KaiManabe/mixer-fader/documents/02.basic-design/basic-design.md

# 基本設計

## ハードウェア構成
### 主要構成要素 - マスターデバイス
- 1x PCB
  - KiCad9.0で設計
  - JLCPCBに発注
- 1x USB type-cメス
- 1x 0.96インチ 80x160px ST7735S搭載IPSディスプレイモジュール
- 2x ロータリーエンコーダ
  - クリック必須
  - プッシュスイッチ必須
- 1x レベルメータ
  - 1x 赤チップLED
  - 5x 橙チップLED
  - 10x 緑チップLED
  - 1x LEDドライバ(TLC5928)
- 1x メス通信端子
  - 3x 5pin ポゴピンコネクタ (メス)
- エンクロージャ
  - 自作もしくはJLC3DP

### 主要構成要素 - スレーブデバイス
- 1x PCB
  - KiCad9.0で設計
  - JLCPCBに発注
- 1x 0.96インチ 80x160px ST7735S搭載IPSディスプレイモジュール
- 1x ロータリーエンコーダ
  - クリック必須
  - プッシュスイッチ必須
- 1x レベルメータ
  - 1x 赤チップLED
  - 5x 橙チップLED
  - 10x 緑チップLED
  - 1x LEDドライバ(TLC5928)
- 1x メス通信端子
  - 3x 5pin ポゴピンコネクタ (メス)
- 1x オス通信端子
  - 3x 5pin ポゴピンコネクタ (オス)
- エンクロージャ
  - 自作もしくはJLC3DP

### 主要構成要素 - エンドキャップ
- 1x PCB
  - KiCad9.0で設計
  - JLCPCBに発注
- 1x オス通信端子
  - 3x 5pin ポゴピンコネクタ (オス)
- エンクロージャ
  - 自作もしくはJLC3DP

## ソフトウェア構成
### ファームウェア
- RP2040 SDKを使用
- C++で実装

#### USB通信
- tinyUSBでGeneric HIDとして振る舞う
  - 開発中はダミーVID/PIDを使用
- 通信フロー
  1. デバイスはサウンドを出力しているアプリケーションの数を要求
  2. winは要求された情報を送信
  3. デバイスは$n$番目のアプリケーションのアイコン，設定音量，レベルを要求
  4. winは要求された情報を送信
  5. 必要に応じて，3,4を繰り返し

#### スレーブ通信
- D-FFおよびシフトレジスタを利用したデイジーチェーン接続を4系統実装
  - 液晶モジュールとのSPI通信のCS信号用 (マスター -> スレーブ)
  - レベルメータのLED用 (マスター -> スレーブ)
  - ロータリーエンコーダの信号選択用 (スレーブ -> マスター)
  - ロータリーエンコーダのプッシュスイッチ用 (スレーブ -> マスター)

### ドライバ
- WASAPIを使用
- C++で実装

#### データ取得・設定
- WASAPIより以下の情報を取得
  - 既定のデバイスから音量を出力するアプリ
  - アプリのアイコン
  - マスターおよび各アプリの設定音量
  - マスターおよび各アプリのミュート情報
  - マスターおよび各アプリの出力レベル
- マスターからの要求に応じて以下の情報を設定
  - マスターもしくは指定アプリの設定音量
  - マスターもしくは指定アプリのミュート

#### USB通信
- VID/PIDによりマスターデバイスを検出
- 検出後，マスターが要求する情報を返し続ける
  - 必要に応じてWASAPI経由で音量設定

## リポジトリ構成
- common/
  - include/*.hpp
    - ファームウェア・ドライバで共通するヘッダを格納
    - 構造体・シリアライザなど
- documents/
  - 01.requirements-definition/*.md
    - 要件定義書
  - 02.basic-design/*.md
    - 基本設計書
  - 03.detailed-design/*.md
    - 詳細設計書
- driver/
  - bin/*.exe
    - 出力exeファイル(git追跡なし)
  - build/*.o
    - ビルドファイル(git追跡なし)
  - include/*.hpp
  - src/*.cpp
  - Makefile
- enclosure/
  - master/*.f3d
    - マスターデバイス用のエンクロージャ
    - Fusion 360プロジェクトファイル
  - slave/*.f3d
    - スレーブデバイス用のエンクロージャ
    - Fusion 360プロジェクトファイル
- firmware/mixer-fader/
  - (RP2040プロジェクトのroot)
  - include/*.hpp
  - src/*.cpp
  - ...
- pcb/mixer-fader/
  - common/footprints
    - フットプリントをすべて配置
  - common/symbols
    - シンボルをすべて配置
  - common/sheets
    - 階層シートをすべて配置
  - master/*
    - KiCadプロジェクトのroot
  - slave/*
    - KiCadプロジェクトのroot
  - endcap/*
    - KiCadプロジェクトのroot
- LICENSE
- README.md
