KaiManabe/mixer-fader/documents/03.detailed-design/enclosure.md

# CAD 詳細設計

## 構成要素
- 1x 筐体
  - マスター用およびスレーブ用を製作
  - 不透明
- 1x レベルメータ用遮光スペーサ
  - 不透明 Black Resin
- 1x レベルメータ用窓
  - 半透明 8001 Resin - Translucent
- 1x LCD用窓
  - 透明 8001 Resin - Transparent
- 1x LCD用スペーサ
  - 素材はなんでもいい

## 要件
### 共通
- PCB正面と筐体裏面の距離は6.5mmとする
  - ロータリーエンコーダに合わせる
- 筐体の厚さは3mmとする

### マスター筐体
- 左側面にUSB-typeCのメスコネクタを刺す穴を持つこと
  - **挿入時，干渉しないこと**
- 左側面にUART用のXHコネクタをに持つこと
  - **挿入時，干渉しないこと**
- 正面にロータリーエンコーダ用の取付穴を2つ持つこと
  - ページ送り用
  - マスターボリューム用
- 正面にLCD用の窓を持つこと
- 正面にレベルメータ用の窓を持つこと
- 右側面にスレーブ接続用の端子を持つこと
  - ダイソーのネオジム磁石を埋め込む穴を持つこと
  - ポゴピンがしっかり接触すること

### スレーブ筐体
- 正面にロータリーエンコーダ用の取付穴を持つこと
  - ボリューム用
- 正面にLCD用の窓を持つこと
- 正面にレベルメータ用の窓を持つこと
- 左側面および右側面にスレーブ接続用の端子を持つこと
  - ダイソーのネオジム磁石を埋め込む穴を持つこと
  - ポゴピンがしっかり接触すること
