KaiManabe/mixer-fader/enclosure/display/spacer.step

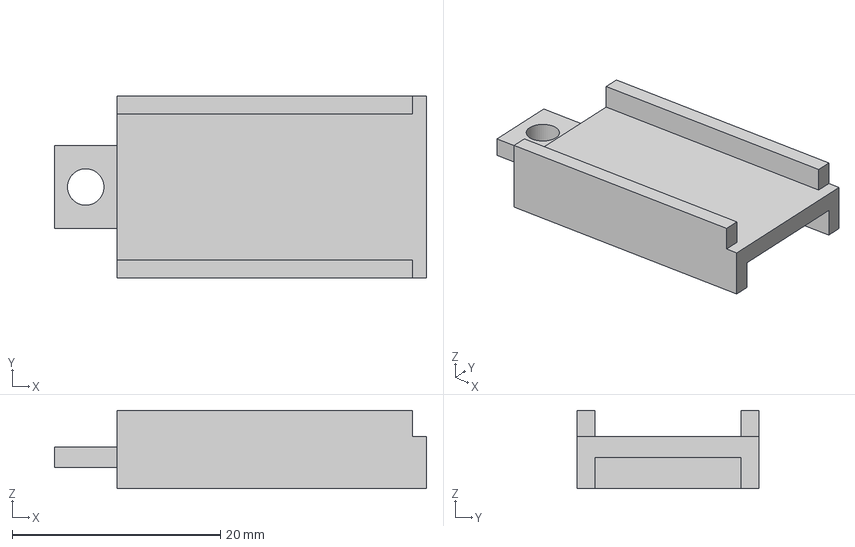
[picture p9: CAD file, 2026-01-30]
enclosure/display/spacer.step
35.8 x 17.5 x 7.50 mm
