KaiManabe/mixer-fader/enclosure/level-meter/spacer/footprint.dxf

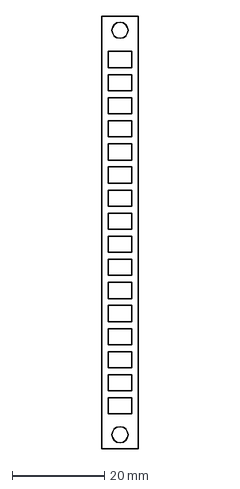
[picture p10: CAD file, 2026-01-30]
enclosure/level-meter/spacer/footprint.dxf
8.00 x 93.6 mm
