KaiManabe/mixer-fader/enclosure/level-meter/window/window.step

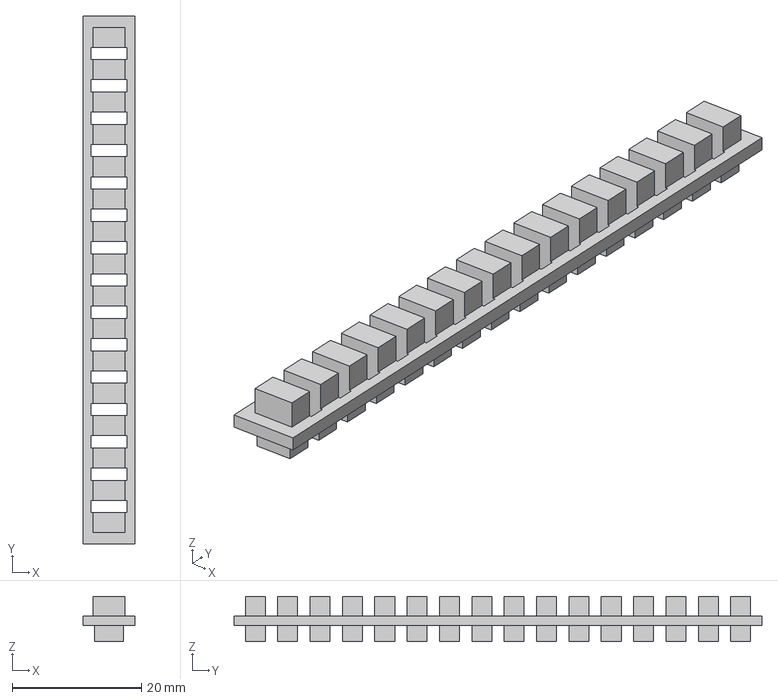
[picture p11: CAD file, 2026-01-30]
enclosure/level-meter/window/window.step
8.00 x 81.6 x 7.00 mm
