KaiManabe/mixer-fader/pcb/mixer-fader/endcap/endcap.step

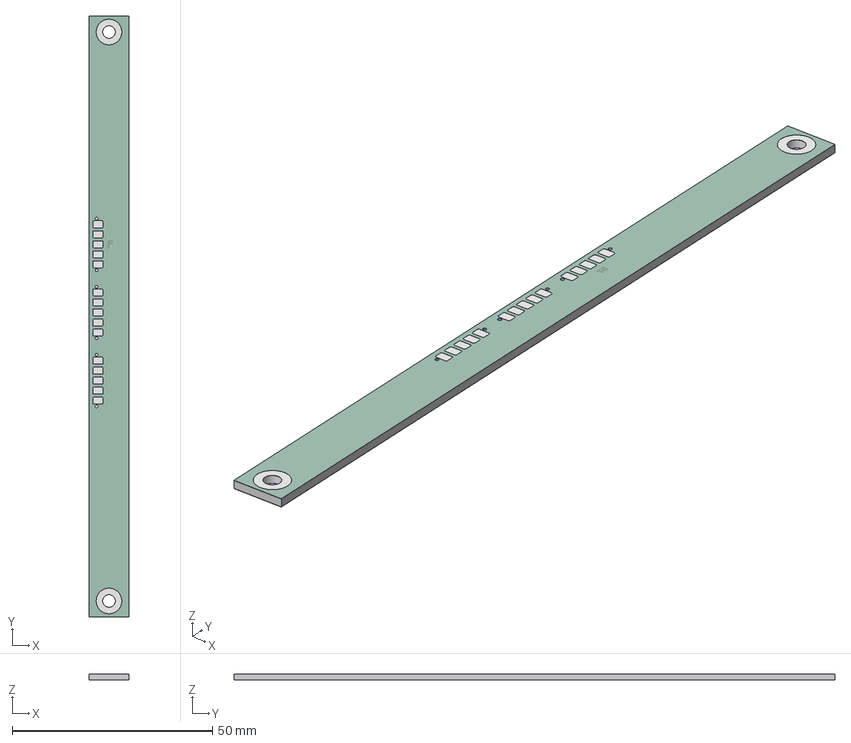
[picture p12: CAD file, 2026-01-30]
pcb/mixer-fader/endcap/endcap.step
10.0 x 150.0 x 1.64 mm
endcap_copper
endcap_pad
endcap_silkscreen
endcap_soldermask x 2
endcap_PCB
