KaiManabe/mixer-fader/pcb/mixer-fader/slave/slave.step

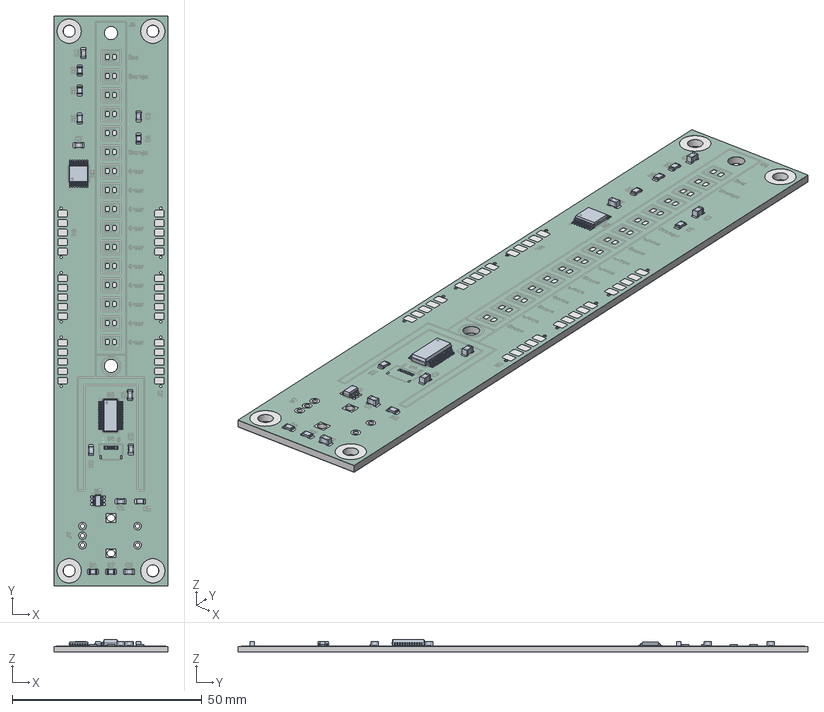
[picture p13: CAD file, 2026-01-30]
pcb/mixer-fader/slave/slave.step
30.0 x 150.0 x 3.29 mm
R_0805_2012Metric x 8
C_0805_2012Metric x 7
SC-74-6_1.55x2.9mm_P0.95mm
TSSOP-16_4.4x5mm_P0.65mm
SSOP-24_3.9x8.7mm_P0.635mm
slave_copper
slave_pad
slave_via
slave_silkscreen
slave_soldermask x 2
slave_PCB
