KaiManabe/mixer-fader/enclosure/display/window.step

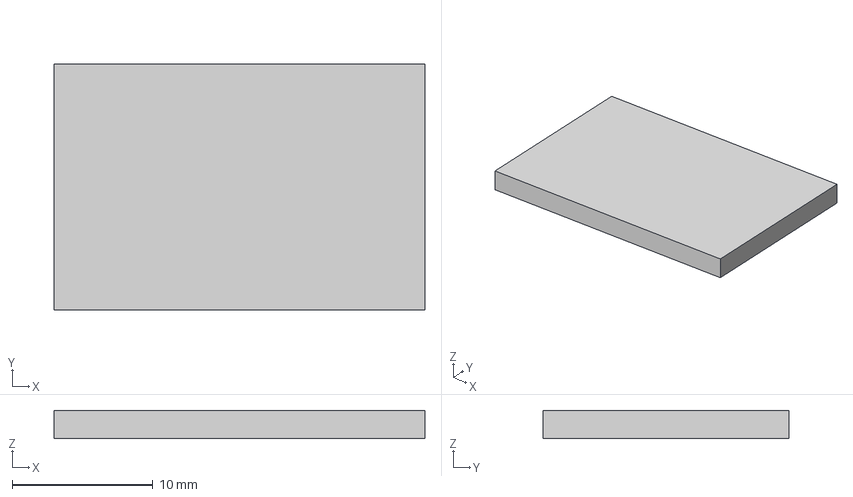
[picture p14: CAD file, 2026-01-30]
enclosure/display/window.step
26.4 x 17.5 x 2.00 mm
