KaiManabe/mixer-fader/enclosure/level-meter/spacer/spacer.step

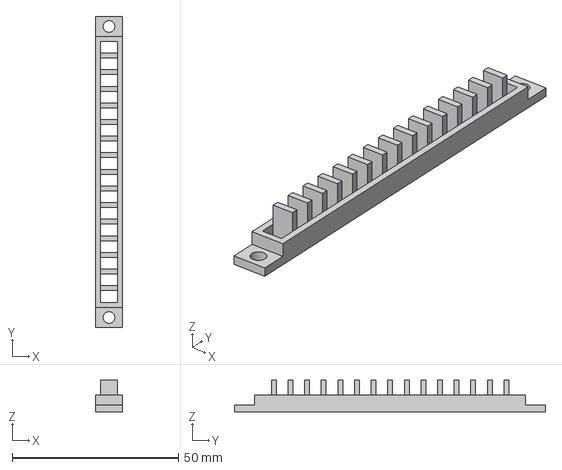
[picture p15: CAD file, 2026-01-30]
enclosure/level-meter/spacer/spacer.step
8.00 x 93.6 x 9.50 mm
