KaiManabe/mixer-fader/enclosure/display/footprint.dxf

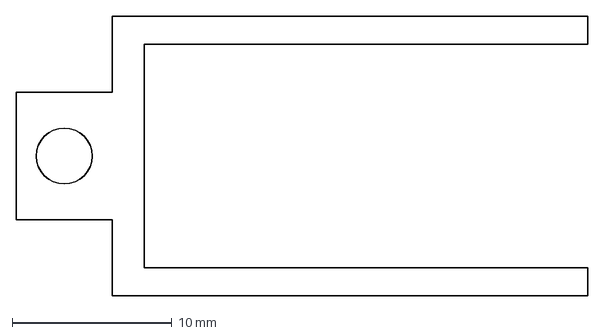
[picture p16: CAD file, 2026-01-30]
enclosure/display/footprint.dxf
35.8 x 17.5 mm
