KaiManabe/mixer-fader/(list of files, cad)

Other CAD files:
enclosure/display/display.f3d
enclosure/level-meter/spacer/spacer.f3d
enclosure/level-meter/window/window.f3d
