KaiManabe/mixer-fader/pcb/mixer-fader/master/master.kicad_pcb

## KiCad design pcb/mixer-fader/master/master.kicad_pcb (2026-01-30)

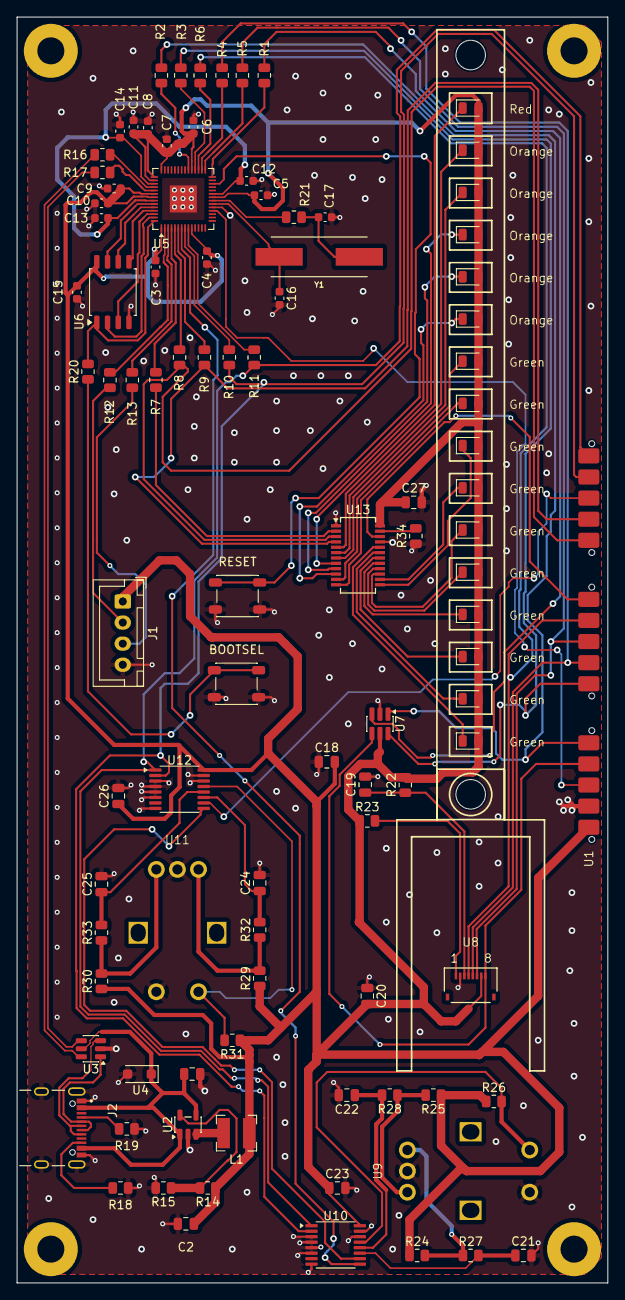
[picture p17: board master.kicad_pcb from above]

Board: 2 copper layers, 70.0 x 150.0 mm, 81 parts (0 on the bottom side), 86 nets.

Parts:
BOOTSEL: BOOTSEL; SW_SPST_PTS647_Sx50
C1, C2: 10u; C_0805_2012Metric
C3, C4, C5, C6, C7, C8, C9, C10, C12, C13, C15: 0.1u; C_0603_1608Metric
C11, C14: 1u; C_0603_1608Metric
C16, C17: 27p; C_0603_1608Metric
C18, C19, C20, C23, C26, C27: 0.1u; C_0805_2012Metric
C21, C22, C24, C25: 0.01u; C_0805_2012Metric
J1: UART_SOCKET; JST_XH_B4B-XH-A_1x04_P2.50mm_Vertical
J2: UJ20-C-H-G-SMT-1-P16-TR
L1: 2.2u; L_Bourns-SRN4018
R1, R2, R3, R4, R5, R6, R7, R8, R9, R10, R11, R16, R17: 27; R_0805_2012Metric
R12, R13: 100; R_0805_2012Metric
R14: 453k; R_0805_2012Metric
R15: 100k; R_0805_2012Metric
R18, R19: 5.1k; R_0805_2012Metric
R20, R21: 1k; R_0805_2012Metric
R22, R24, R25, R26, R27, R28, R29, R30, R31, R32, R33: 10k; R_0805_2012Metric
R23: 18; R_0805_2012Metric
R34: 2.7k; R_0805_2012Metric
RESET: RESET; SW_SPST_PTS647_Sx50
U1: MixerFader_PogoPin_Male; 3x_PogoPinConnector_SMD_Male_01x05
U2: TLV62568DBV; SOT-23-5
U3: USBLC6-2SC6; SOT-23-6
U4: SMF5.0CA; D_SOD-123F
U5: RP2040; QFN-56-1EP_7x7mm_P0.4mm_EP3.2x3.2mm
U6: W25Q128JVS; SOIC-8_5.3x5.3mm_P1.27mm
U7: 74LVC1G175; SC-74-6_1.55x2.9mm_P0.95mm
U8: ST7735_FPC; ST7735_PFC_Inverted
U9, U11: EC11
U10, U12: 74LV165PW-Q100J; TSSOP-16_4.4x5mm_P0.65mm
U13: TLC59283DBQR; SSOP-24_3.9x8.7mm_P0.635mm
U14: LevelMeter_16
Y1: ABLS-12.000MHZ-B4-T

Connections:
+3V3: C2.1, C3.1, C4.1, C5.1, C6.1, C7.1, C8.1, C9.1, C10.1, C11.1, C15.1, C18.2, C20.2, C23.1, C26.1, C27.1, J1.1, L1.2, R14.1, R22.2, R23.1, R24.1, R25.1, R26.1, R29.1, R30.1, R31.1, U1.1 (3.3V), U5.1 (IOVDD), U5.10 (IOVDD), U5.22 (IOVDD), U5.33 (IOVDD), U5.42 (IOVDD), U5.43 (ADC_AVDD), U5.44 (VREG_VIN), U5.48 (USB_VDD), U5.49 (IOVDD), U6.8 (VCC), U7.5 (VCC), U8.7 (VCC), U10.16 (VCC), U12.16 (VCC), U13.24 (VCC), U14.2, U14.4, U14.6, U14.8, U14.10, U14.12, U14.14, U14.16, U14.18, U14.20, U14.22, U14.24, U14.26, U14.28, U14.30, U14.32
/Master_Display/DFF-CLK: R2.2, U1.5 (DISP_DFF_CLK), U7.1 (CLK)
/Master_Display/DFF-CLR: R3.2, U1.6 (DISP_DFF_CLR), U7.6 (~CLR)
/Master_Display/DFF-D: R1.2, U7.3 (D)
/Master_Display/DFF-Q: U1.4 (DISP_DFF_D), U7.4 (Q), U8.8 (CS)
/Master_Display/SPI-CLK: R5.2, U1.8 (DISP_SPI_CLK), U8.6 (SCL)
/Master_Display/SPI-DC: R6.2, U1.9 (DISP_DC), U8.4 (DC)
/Master_Display/SPI-MOSI: R4.2, U1.7 (DISP_SPI_MOSI), U8.5 (SDA)
/Master_LevelMeter/CLK: R8.2, U1.11 (LED_CLK), U13.3 (SCLK)
/Master_LevelMeter/DATA-IN: R7.2, U13.2 (SIN)
/Master_LevelMeter/DATA-OUT: U1.10 (LED_DATA), U13.22 (SOUT)
/Master_LevelMeter/LATCH: R9.2, U1.12 (LED_LATCH), U13.4 (LAT)
/Page_Encoder/CLK: R10.2, U1.14 (ENC_LATCH), U10.2 (CP), U12.2 (CP)
/Page_Encoder/DATA-IN: U1.13 (ENC_DATA), U12.10 (DS)
/Page_Encoder/DATA-OUT: U10.10 (DS), U12.9 (Q7)
/Page_Encoder/LATCH: R11.2, U1.15 (ENC_CLK), U10.1 (~PL), U12.1 (~PL)
/RP2040/1.1V: C12.1, C13.1, C14.1, U5.23 (DVDD), U5.45 (VREG_VOUT), U5.50 (DVDD)
/RP2040/GPIO0: R12.1, U5.2 (GPIO0)
/RP2040/GPIO1: R13.1, U5.3 (GPIO1)
/RP2040/GPIO2: R7.1, U5.4 (GPIO2)
/RP2040/GPIO3: R8.1, U5.5 (GPIO3)
/RP2040/GPIO4: R9.1, U5.6 (GPIO4)
/RP2040/GPIO5: U5.7 (GPIO5), U10.9 (Q7)
/RP2040/GPIO6: R10.1, U5.8 (GPIO6)
/RP2040/GPIO7: R11.1, U5.9 (GPIO7)
/RP2040/GPIO15: U1.3 (DISP_LOOPBACK), U5.18 (GPIO15)
/RP2040/GPIO17: R1.1, U5.28 (GPIO17)
/RP2040/GPIO18: R5.1, U5.29 (GPIO18)
/RP2040/GPIO19: R4.1, U5.30 (GPIO19)
/RP2040/GPIO20: R6.1, U5.31 (GPIO20)
/RP2040/GPIO21: R3.1, U5.32 (GPIO21)
/RP2040/GPIO22: R2.1, U5.34 (GPIO22)
/RP2040/QSPI_SCLK: U5.52 (QSPI_SCLK), U6.6 (CLK)
/RP2040/QSPI_SD0: U5.53 (QSPI_SD0), U6.5 (DI/IO_{0})
/RP2040/QSPI_SD1: U5.55 (QSPI_SD1), U6.2 (DO/IO_{1})
/RP2040/QSPI_SD2: U5.54 (QSPI_SD2), U6.3 (~WP/IO_{2})
/RP2040/QSPI_SD3: U5.51 (QSPI_SD3), U6.7 (~HOLD/~RESET/IO_{3})
/RP2040/RUN: RESET.1, U5.26 (RUN)
/RP2040/USB_DN: R16.1, U3.6 (I/O1)
/RP2040/USB_DP: R17.1, U3.4 (I/O2)
/RP2040/USB_VBUS: C1.1, J2.A4_B9 (VBUS), J2.B4_A9 (VBUS__1), U2.1 (EN), U2.4 (VIN), U3.5 (VBUS), U4.1
/RP2040/XIN: C16.1, U5.20 (XIN), Y1.1
/RP2040/XOUT: R21.2, U5.21 (XOUT)
/RP2040/~QSPI_SS: R20.2, U5.56 (~QSPI_SS), U6.1 (~CS)
/RP2040/~USB_BOOT: BOOTSEL.1, R20.1
GND: BOOTSEL.2, C1.2, C2.2, C3.2, C4.2, C5.2, C6.2, C7.2, C8.2, C9.2, C10.2, C11.2, C12.2, C13.2, C14.2, C15.2, C16.2, C17.2, C18.1, C19.2, C20.1, C21.2, C22.2, C23.2, C24.2, C25.2, C26.2, C27.2, J1.4, J2.A1_B12 (GND), J2.B1_A12 (GND__1), J2.SH1 (SHIELD), J2.SH2 (SHIELD__1), J2.SH3 (SHIELD__2), J2.SH4 (SHIELD__3), R15.2, R18.2, R19.2, R34.1, RESET.2, U1.2 (GND), U2.2 (GND), U3.2 (GND), U4.2, U5.19 (TESTEN), U5.57 (GND), U6.4 (GND), U7.2 (GND), U8.2 (GND), U9.C, U9.S1, U10.3 (D4), U10.4 (D5), U10.5 (D6), U10.6 (D7), U10.8 (GND), U10.14 (D3), U10.15 (~CE), U11.C, U11.S1, U12.3 (D4), U12.4 (D5), U12.5 (D6), U12.6 (D7), U12.8 (GND), U12.14 (D3), U12.15 (~CE), U13.1 (GND), U13.21 (BLANK)
unnamed: C17.1, R21.1, Y1.2
unnamed: J1.2, R12.2
unnamed: J1.3, R13.2
unnamed: J2.A5 (CC1), R19.1
unnamed: J2.B5 (CC2), R18.1
unnamed: J2.A7 (DN1), J2.B7 (DN2), U3.1 (I/O1)
unnamed: J2.A6 (DP1), J2.B6 (DP2), U3.3 (I/O2)
unnamed: R24.2, R27.1, U9.A
unnamed: R25.2, R28.1, U9.B
unnamed: R29.2, R32.1, U11.A
unnamed: R30.2, R33.1, U11.B
unnamed: R14.2, R15.1, U2.5 (FB)
unnamed: L1.1, U2.3 (SW)
unnamed: R16.2, U5.46 (USB_DM)
unnamed: R17.2, U5.47 (USB_DP)
unnamed: R23.2, U8.1 (LEDA)
unnamed: C19.1, R22.1, U8.3 (RESET)
unnamed: C21.1, R27.2, U10.11 (D0)
unnamed: C22.1, R28.2, U10.12 (D1)
unnamed: R26.2, U9.S2, U10.13 (D2)
unnamed: C24.1, R32.2, U12.11 (D0)
unnamed: C25.1, R33.2, U12.12 (D1)
unnamed: R31.2, U11.S2, U12.13 (D2)
unnamed: R34.2, U13.23 (IREF)
unnamed: U13.5 (OUT0), U14.1
unnamed: U13.6 (OUT1), U14.3
unnamed: U13.7 (OUT2), U14.5
unnamed: U13.8 (OUT3), U14.7
unnamed: U13.9 (OUT4), U14.9
unnamed: U13.10 (OUT5), U14.11
unnamed: U13.11 (OUT6), U14.13
unnamed: U13.12 (OUT7), U14.15
unnamed: U13.13 (OUT8), U14.17
unnamed: U13.14 (OUT9), U14.19
unnamed: U13.15 (OUT10), U14.21
unnamed: U13.16 (OUT11), U14.23
unnamed: U13.17 (OUT12), U14.25
unnamed: U13.18 (OUT13), U14.27
unnamed: U13.19 (OUT14), U14.29
unnamed: U13.20 (OUT15), U14.31
