KaiManabe/mixer-fader/pcb/mixer-fader/slave/slave.kicad_pcb

## KiCad design pcb/mixer-fader/slave/slave.kicad_pcb (2026-01-30)

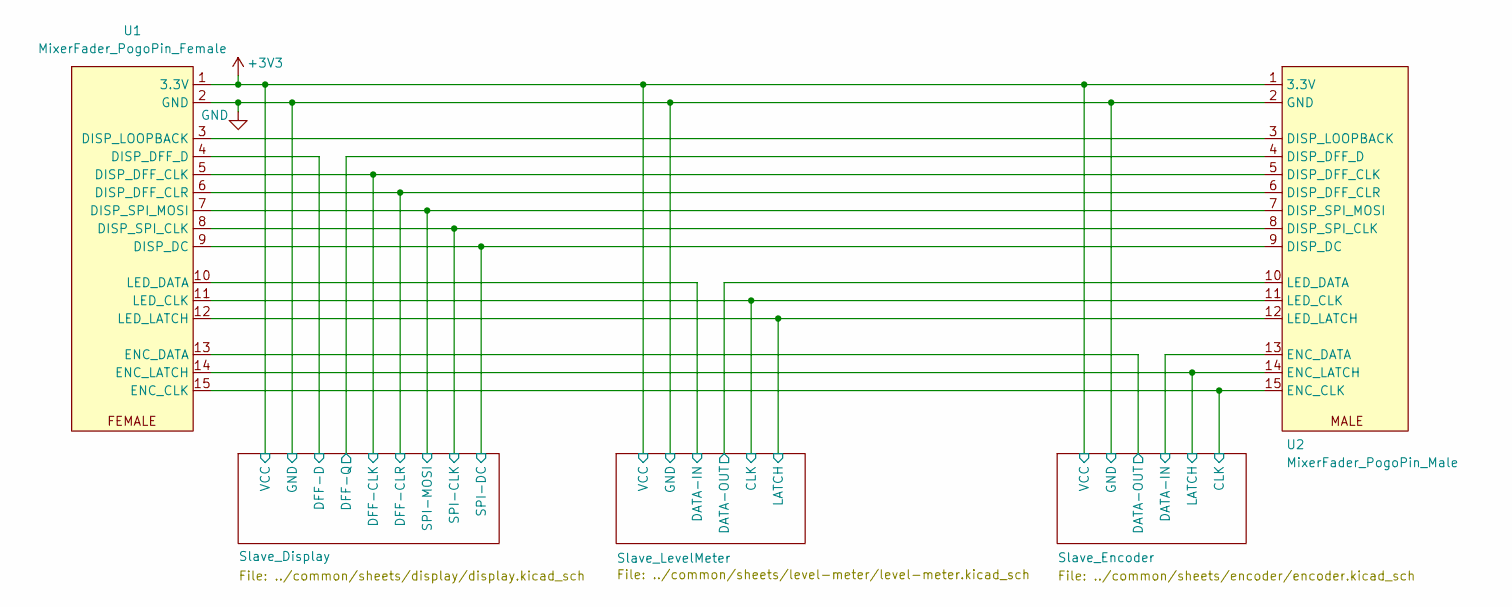
[picture p18: schematic slave.kicad_sch]

Parts:
U1: MixerFader_PogoPin_Female; 3x_PogoPinConnector_SMD_Female_01x05_1_1
U2: MixerFader_PogoPin_Male; 3x_PogoPinConnector_SMD_Male_01x05

Connections:
+3V3: U1.1 (3.3V), U2.1 (3.3V); also elsewhere on the board
/Slave_Display/DFF-CLK: U1.5 (DISP_DFF_CLK), U2.5 (DISP_DFF_CLK); also elsewhere on the board
/Slave_Display/DFF-CLR: U1.6 (DISP_DFF_CLR), U2.6 (DISP_DFF_CLR); also elsewhere on the board
/Slave_Display/DFF-D: U1.4 (DISP_DFF_D); also elsewhere on the board
/Slave_Display/DFF-Q: U2.4 (DISP_DFF_D); also elsewhere on the board
/Slave_Display/SPI-CLK: U1.8 (DISP_SPI_CLK), U2.8 (DISP_SPI_CLK); also elsewhere on the board
/Slave_Display/SPI-DC: U1.9 (DISP_DC), U2.9 (DISP_DC); also elsewhere on the board
/Slave_Display/SPI-MOSI: U1.7 (DISP_SPI_MOSI), U2.7 (DISP_SPI_MOSI); also elsewhere on the board
/Slave_Encoder/CLK: U1.15 (ENC_CLK), U2.15 (ENC_CLK); also elsewhere on the board
/Slave_Encoder/DATA-IN: U2.13 (ENC_DATA); also elsewhere on the board
/Slave_Encoder/DATA-OUT: U1.13 (ENC_DATA); also elsewhere on the board
/Slave_Encoder/LATCH: U1.14 (ENC_LATCH), U2.14 (ENC_LATCH); also elsewhere on the board
/Slave_LevelMeter/CLK: U1.11 (LED_CLK), U2.11 (LED_CLK); also elsewhere on the board
/Slave_LevelMeter/DATA-IN: U1.10 (LED_DATA); also elsewhere on the board
/Slave_LevelMeter/DATA-OUT: U2.10 (LED_DATA); also elsewhere on the board
/Slave_LevelMeter/LATCH: U1.12 (LED_LATCH), U2.12 (LED_LATCH); also elsewhere on the board
GND: U1.2 (GND), U2.2 (GND); also elsewhere on the board
unnamed: U1.3 (DISP_LOOPBACK), U2.3 (DISP_LOOPBACK)

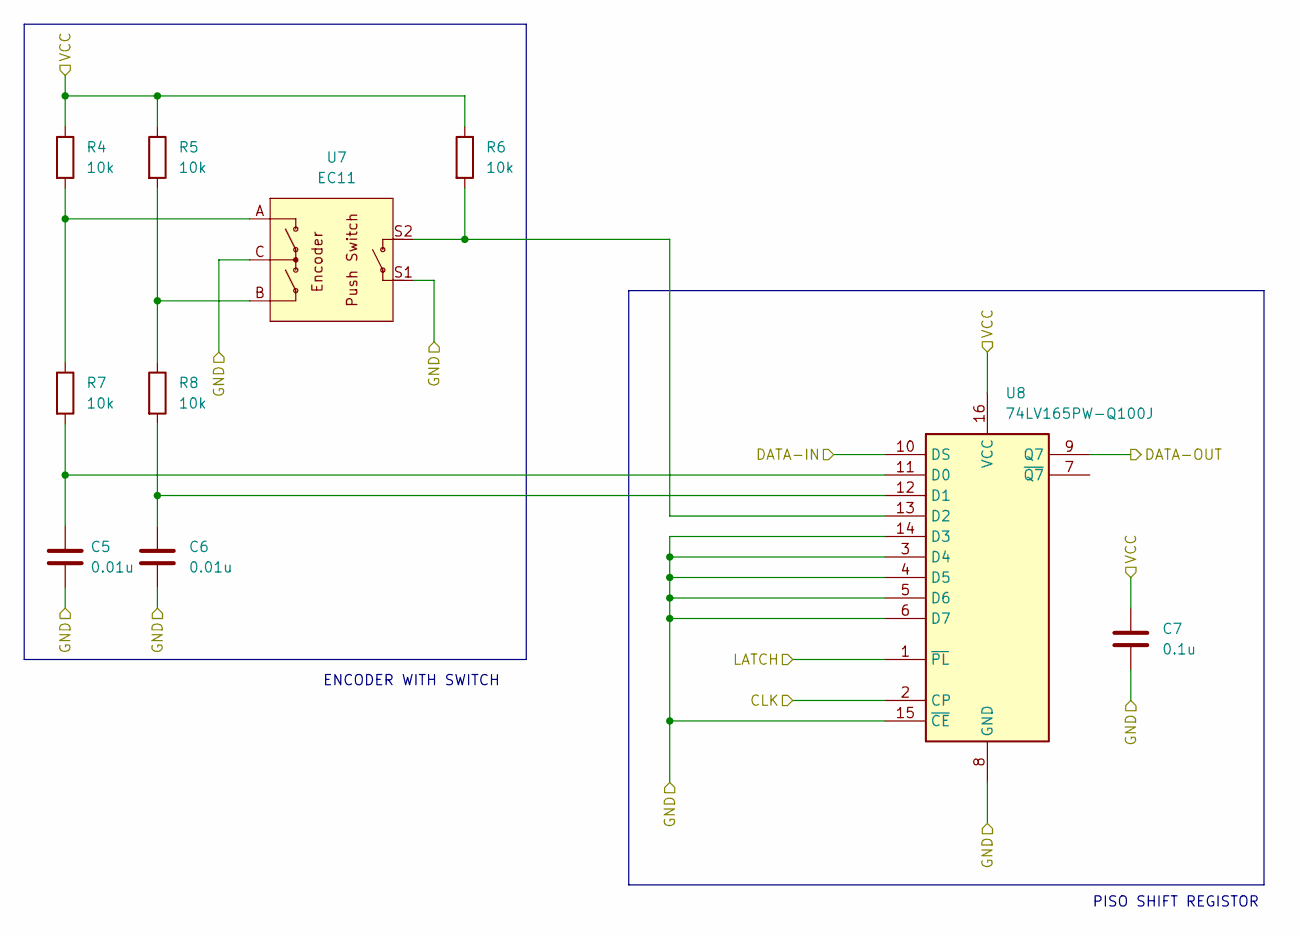
[picture p19: schematic encoder.kicad_sch]

Parts:
C5, C6: 0.01u; C_0805_2012Metric
C7: 0.1u; C_0805_2012Metric
R4, R5, R6, R7, R8: 10k; R_0805_2012Metric
U7: EC11
U8: 74LV165PW-Q100J; TSSOP-16_4.4x5mm_P0.65mm

Connections:
+3V3: C7.1, R4.1, R5.1, R6.1, U8.16 (VCC); also elsewhere on the board
/Slave_Encoder/CLK: U8.2 (CP); also elsewhere on the board
/Slave_Encoder/DATA-IN: U8.10 (DS); also elsewhere on the board
/Slave_Encoder/DATA-OUT: U8.9 (Q7); also elsewhere on the board
/Slave_Encoder/LATCH: U8.1 (~PL); also elsewhere on the board
GND: C5.2, C6.2, C7.2, U7.C, U7.S1, U8.3 (D4), U8.4 (D5), U8.5 (D6), U8.6 (D7), U8.8 (GND), U8.14 (D3), U8.15 (~CE); also elsewhere on the board
unnamed: R4.2, R7.1, U7.A
unnamed: R5.2, R8.1, U7.B
unnamed: C5.1, R7.2, U8.11 (D0)
unnamed: C6.1, R8.2, U8.12 (D1)
unnamed: R6.2, U7.S2, U8.13 (D2)

Notes on the sheet:
PISO SHIFT REGISTOR
ENCODER WITH SWITCH

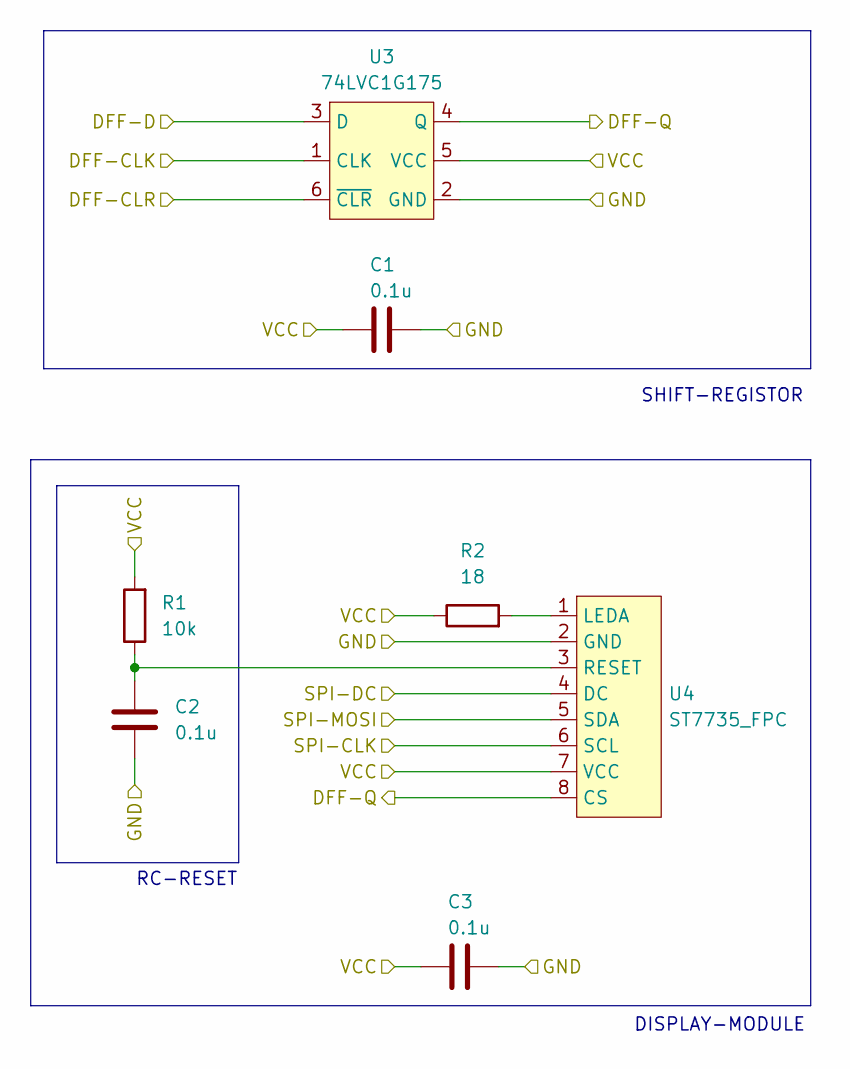
[picture p20: schematic display.kicad_sch]

Parts:
C1, C2, C3: 0.1u; C_0805_2012Metric
R1: 10k; R_0805_2012Metric
R2: 18; R_0805_2012Metric
U3: 74LVC1G175; SC-74-6_1.55x2.9mm_P0.95mm; MPN 74LVC1G175GV
U4: ST7735_FPC; ST7735_PFC_Inverted

Connections:
+3V3: C1.2, C3.2, R1.2, R2.1, U3.5 (VCC), U4.7 (VCC); also elsewhere on the board
/Slave_Display/DFF-CLK: U3.1 (CLK); also elsewhere on the board
/Slave_Display/DFF-CLR: U3.6 (~CLR); also elsewhere on the board
/Slave_Display/DFF-D: U3.3 (D); also elsewhere on the board
/Slave_Display/DFF-Q: U3.4 (Q), U4.8 (CS); also elsewhere on the board
/Slave_Display/SPI-CLK: U4.6 (SCL); also elsewhere on the board
/Slave_Display/SPI-DC: U4.4 (DC); also elsewhere on the board
/Slave_Display/SPI-MOSI: U4.5 (SDA); also elsewhere on the board
GND: C1.1, C2.2, C3.1, U3.2 (GND), U4.2 (GND); also elsewhere on the board
unnamed: R2.2, U4.1 (LEDA)
unnamed: C2.1, R1.1, U4.3 (RESET)

Notes on the sheet:
SHIFT-REGISTOR
DISPLAY-MODULE
RC-RESET

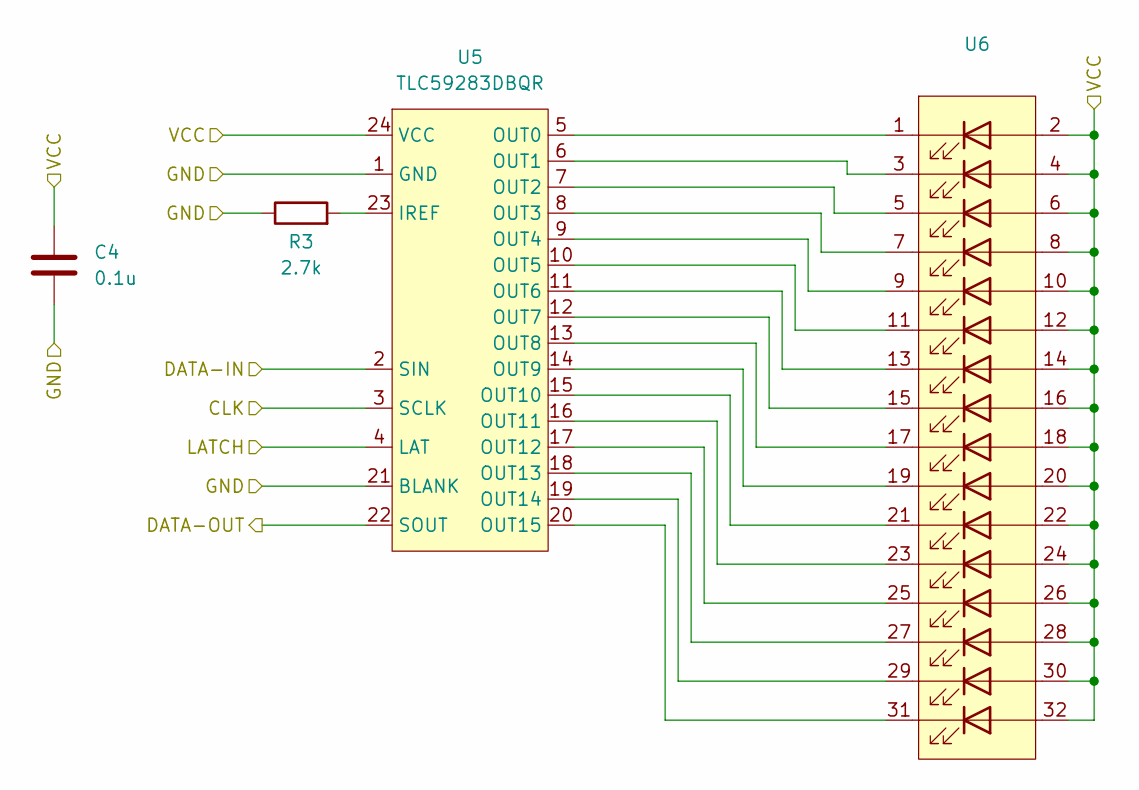
[picture p21: schematic level-meter.kicad_sch]

Parts:
C4: 0.1u; C_0805_2012Metric
R3: 2.7k; R_0805_2012Metric
U5: TLC59283DBQR; SSOP-24_3.9x8.7mm_P0.635mm
U6: LevelMeter_16

Connections:
+3V3: C4.1, U5.24 (VCC), U6.2, U6.4, U6.6, U6.8, U6.10, U6.12, U6.14, U6.16, U6.18, U6.20, U6.22, U6.24, U6.26, U6.28, U6.30, U6.32; also elsewhere on the board
/Slave_LevelMeter/CLK: U5.3 (SCLK); also elsewhere on the board
/Slave_LevelMeter/DATA-IN: U5.2 (SIN); also elsewhere on the board
/Slave_LevelMeter/DATA-OUT: U5.22 (SOUT); also elsewhere on the board
/Slave_LevelMeter/LATCH: U5.4 (LAT); also elsewhere on the board
GND: C4.2, R3.1, U5.1 (GND), U5.21 (BLANK); also elsewhere on the board
unnamed: R3.2, U5.23 (IREF)
unnamed: U5.5 (OUT0), U6.1
unnamed: U5.6 (OUT1), U6.3
unnamed: U5.7 (OUT2), U6.5
unnamed: U5.8 (OUT3), U6.7
unnamed: U5.9 (OUT4), U6.9
unnamed: U5.10 (OUT5), U6.11
unnamed: U5.11 (OUT6), U6.13
unnamed: U5.12 (OUT7), U6.15
unnamed: U5.13 (OUT8), U6.17
unnamed: U5.14 (OUT9), U6.19
unnamed: U5.15 (OUT10), U6.21
unnamed: U5.16 (OUT11), U6.23
unnamed: U5.17 (OUT12), U6.25
unnamed: U5.18 (OUT13), U6.27
unnamed: U5.19 (OUT14), U6.29
unnamed: U5.20 (OUT15), U6.31

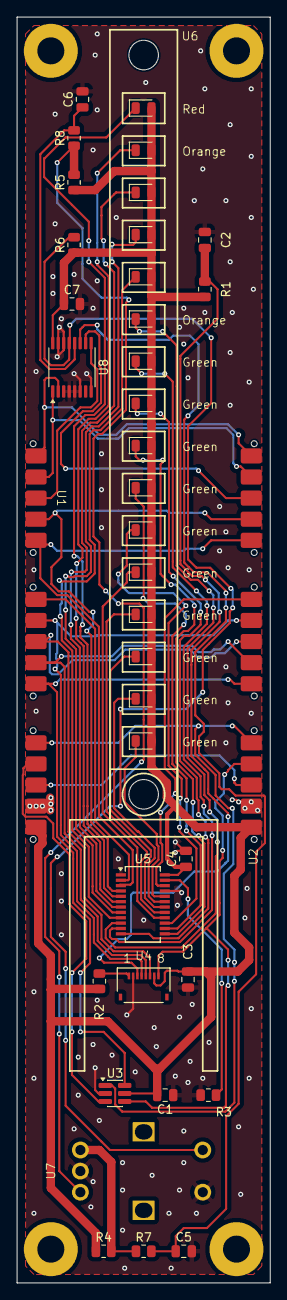
[picture p22: board slave.kicad_pcb from above]

Board: 2 copper layers, 30.0 x 150.0 mm, 23 parts (0 on the bottom side), 42 nets.
