KaiManabe/mixer-fader/(commit log)

2026-01-04 Initialized KiCad project
    [mixer-fader.kicad_pcb, mixer-fader.kicad_sch]
2026-01-08 Add detailed-design of PCB
2026-01-08 Split KiCad project
    [endcap.kicad_pcb, endcap.kicad_sch, master.kicad_pcb, master.kicad_sch, slave.kicad_pcb, slave.kicad_sch]
2026-01-11 Add detailed-design of enclosure
2026-01-11 Add enclosure of level-meter
    [footprint.dxf, spacer.f3d, spacer.step, window.f3d, window.step]
2026-01-11 Add enclosure of display
    [display.f3d, footprint.dxf, spacer.step, window.step]
2026-01-11 Fix enclosure of display
    [display.f3d, footprint.dxf, spacer.step]
2026-01-12 Add common symbols, footprints, sheets
    [display.kicad_pcb, display.kicad_sch, encoder.kicad_pcb, encoder.kicad_sch, level-meter.kicad_pcb, level-meter.kicad_sch, rp2040.kicad_pcb, rp2040.kicad_sch]
2026-01-12 Add master pcb
    [master.kicad_pcb, master.kicad_sch]
2026-01-12 Add slave pcb
    [slave.kicad_pcb, slave.kicad_sch, slave.step]
2026-01-12 Add endcap pcb
    [endcap.kicad_pcb, endcap.kicad_sch, endcap.step]
2026-01-12 Orderd PCB and Spacer, Window
    [display.kicad_sch, encoder.kicad_sch, level-meter.kicad_sch]
2026-01-30 Add BOM
    [master.csv, slave.csv]
